tresuren/FC-EXPSYNTH/hardware/RevE5/docs/pcb_render.png

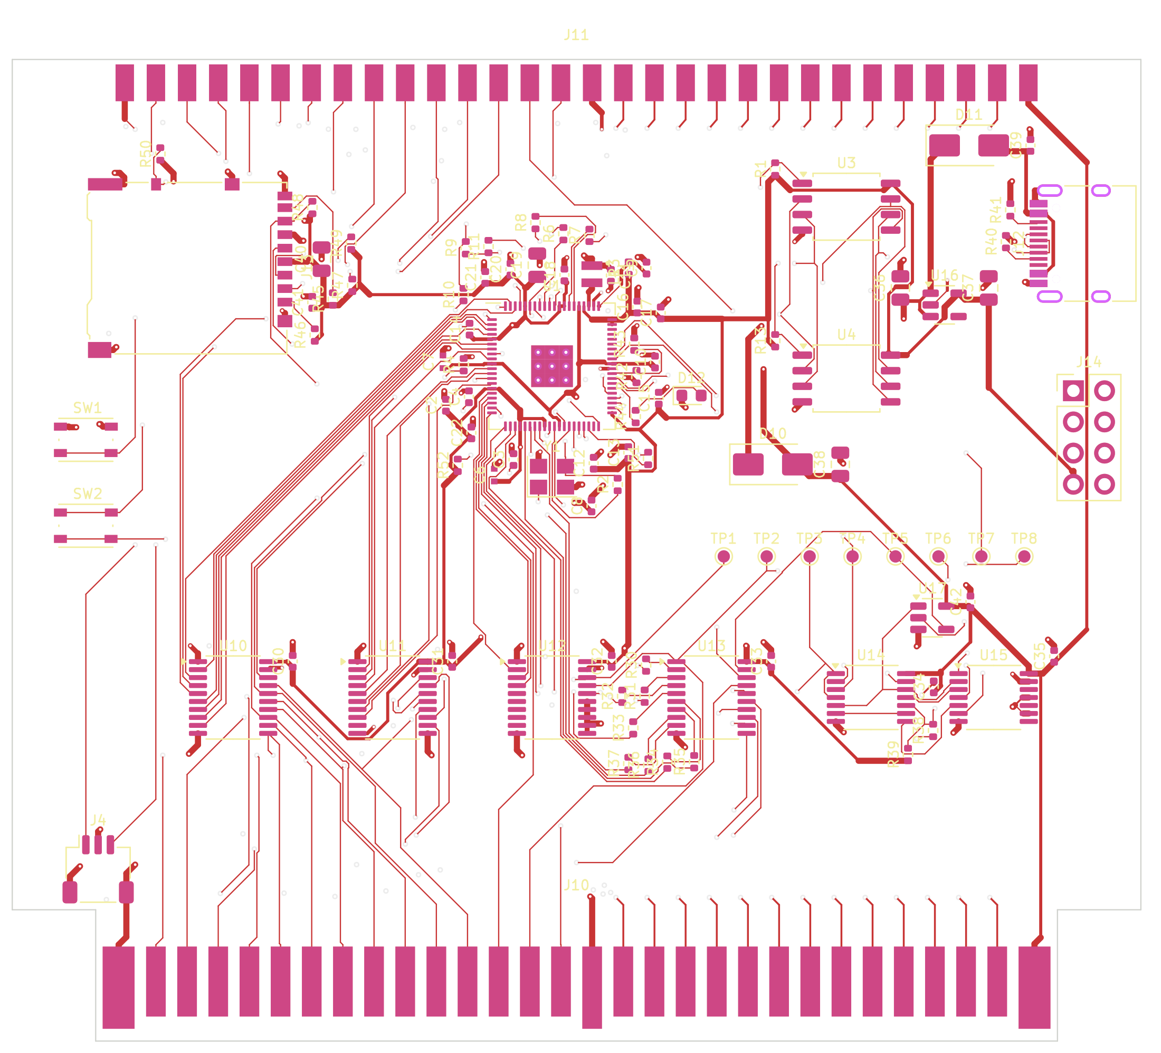
hardware/RevE5/docs/pcb_render.png
