tresuren/FC-EXPSYNTH/hardware/RevE5/docs/pcb_render_back.png

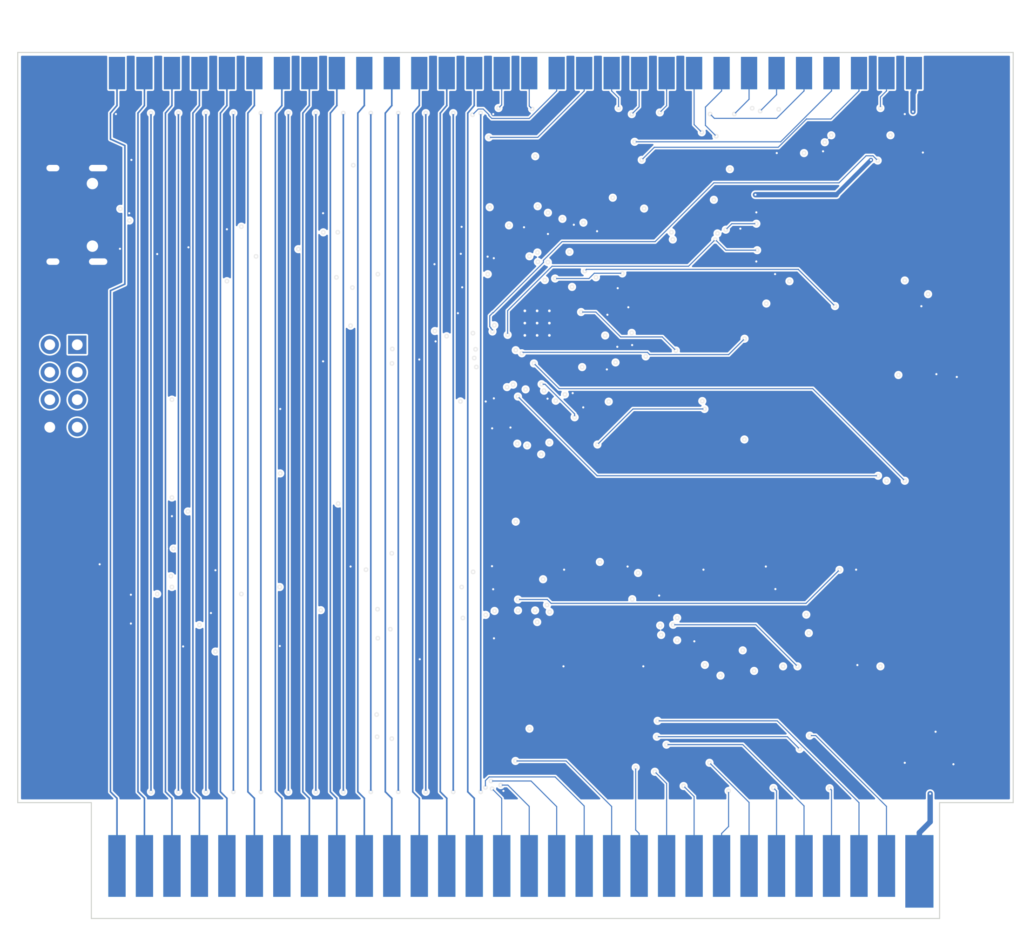
hardware/RevE5/docs/pcb_render_back.png
