tresuren/FC-EXPSYNTH/hardware/RevE5/BOM.csv

Designators | Qty | Value | Footprint | MPN/LCSC (UNVERIFIED - choose yourself)
C2 C8 C11 C12 C13 C14 C15 C16 C17 C18 C20 C21 C30 C31 C32 C33 C34 C35 C39 C41 C42 | 21 | 100n | C_0402_1005Metric
C3 C4 | 2 | 15p | C_0402_1005Metric
C6 C7 | 2 | 4.7u | C_0402_1005Metric_small_pads
C9 C10 | 2 | 4.7u | C_0402_1005Metric
C19 C36 C37 C40 | 4 | 10u | C_0805_2012Metric
C22 | 1 | DNF | C_0402_1005Metric
C38 | 1 | 22u | C_0805_2012Metric
D10 D11 | 2 | SS14 | D_SMA
D12 | 1 | green | LED_0603_1608Metric
J4 | 1 | SM03B-SRSS-TB | JST_SH_SM03B-SRSS-TB_1x03-1MP_P1.00mm_Horizontal
J10 | 1 | FC_Cart_Edge_60 | FC_Cart_Edge_60
J11 | 1 | FC_Slot_60 (expansion cart) | FC_Slot_60 | hand-solder
J12 | 1 | USB-C (HRO TYPE-C-31-M-12) | USB_C_Receptacle_HRO_TYPE-C-31-M-12
J13 | 1 | microSD (SPI) | microSD_HC_Hirose_DM3AT-SF-PEJM5
J14 | 1 | Spare GPIO | PinHeader_2x04_P2.54mm_Vertical
L1 | 1 | 3.3u | L_pol_2016
R1 R9 R11 R13 | 4 | DNF | R_0402_1005Metric
R2 R4 R6 R38 R44 R51 | 6 | 1k | R_0402_1005Metric
R3 | 1 | 33 | R_0402_1005Metric
R7 R8 | 2 | 27 | R_0402_1005Metric
R10 | 1 | 0 | R_0402_1005Metric
R30 R31 R32 R33 R34 R35 R36 R37 | 8 | 330 | R_0402_1005Metric
R39 R42 R45 R46 R47 R48 R49 R50 R52 | 9 | 10k | R_0402_1005Metric
R40 R41 | 2 | 5.1k | R_0402_1005Metric
R43 | 1 | 15k | R_0402_1005Metric
SW1 SW2 | 2 | SW_Push | SW_Push_1P1T_NO_Vertical_Wuerth_434133025816
TP1 | 1 | M2 | TestPoint_Pad_D1.0mm | not assembled (pads only)
TP2 | 1 | RW | TestPoint_Pad_D1.0mm | not assembled (pads only)
TP3 | 1 | ROMSEL_N | TestPoint_Pad_D1.0mm | not assembled (pads only)
TP4 | 1 | ROMSEL_EXP | TestPoint_Pad_D1.0mm | not assembled (pads only)
TP5 | 1 | OE_N | TestPoint_Pad_D1.0mm | not assembled (pads only)
TP6 | 1 | EN_N | TestPoint_Pad_D1.0mm | not assembled (pads only)
TP7 | 1 | GAME | TestPoint_Pad_D1.0mm | not assembled (pads only)
TP8 | 1 | IRQ_N | TestPoint_Pad_D1.0mm | not assembled (pads only)
U1 | 1 | RP2350_80QFN | RP2350-QFN-80-1EP_10x10_P0.4mm_EP3.4x3.4mm_ThermalVias
U3 | 1 | W25Q128JVS | SOIC-8_5.23x5.23mm_P1.27mm
U4 | 1 | DNF | SOIC-8_5.23x5.23mm_P1.27mm
U10 U11 U12 U13 | 4 | 74LVC245 | TSSOP-20_4.4x6.5mm_P0.65mm
U14 | 1 | 74HCT32 | TSSOP-14_4.4x5mm_P0.65mm
U15 | 1 | 74HC04 | TSSOP-14_4.4x5mm_P0.65mm
U16 | 1 | AP2112K-3.3 | SOT-23-5
U17 | 1 | 74LVC1G02 | SOT-23-5
Y1 | 1 | ABM8-272-T3 | Crystal_SMD_3225-4Pin_3.2x2.5mm
