tresuren/FC-EXPSYNTH/hardware/RevE5/docs/fc_sch.pdf

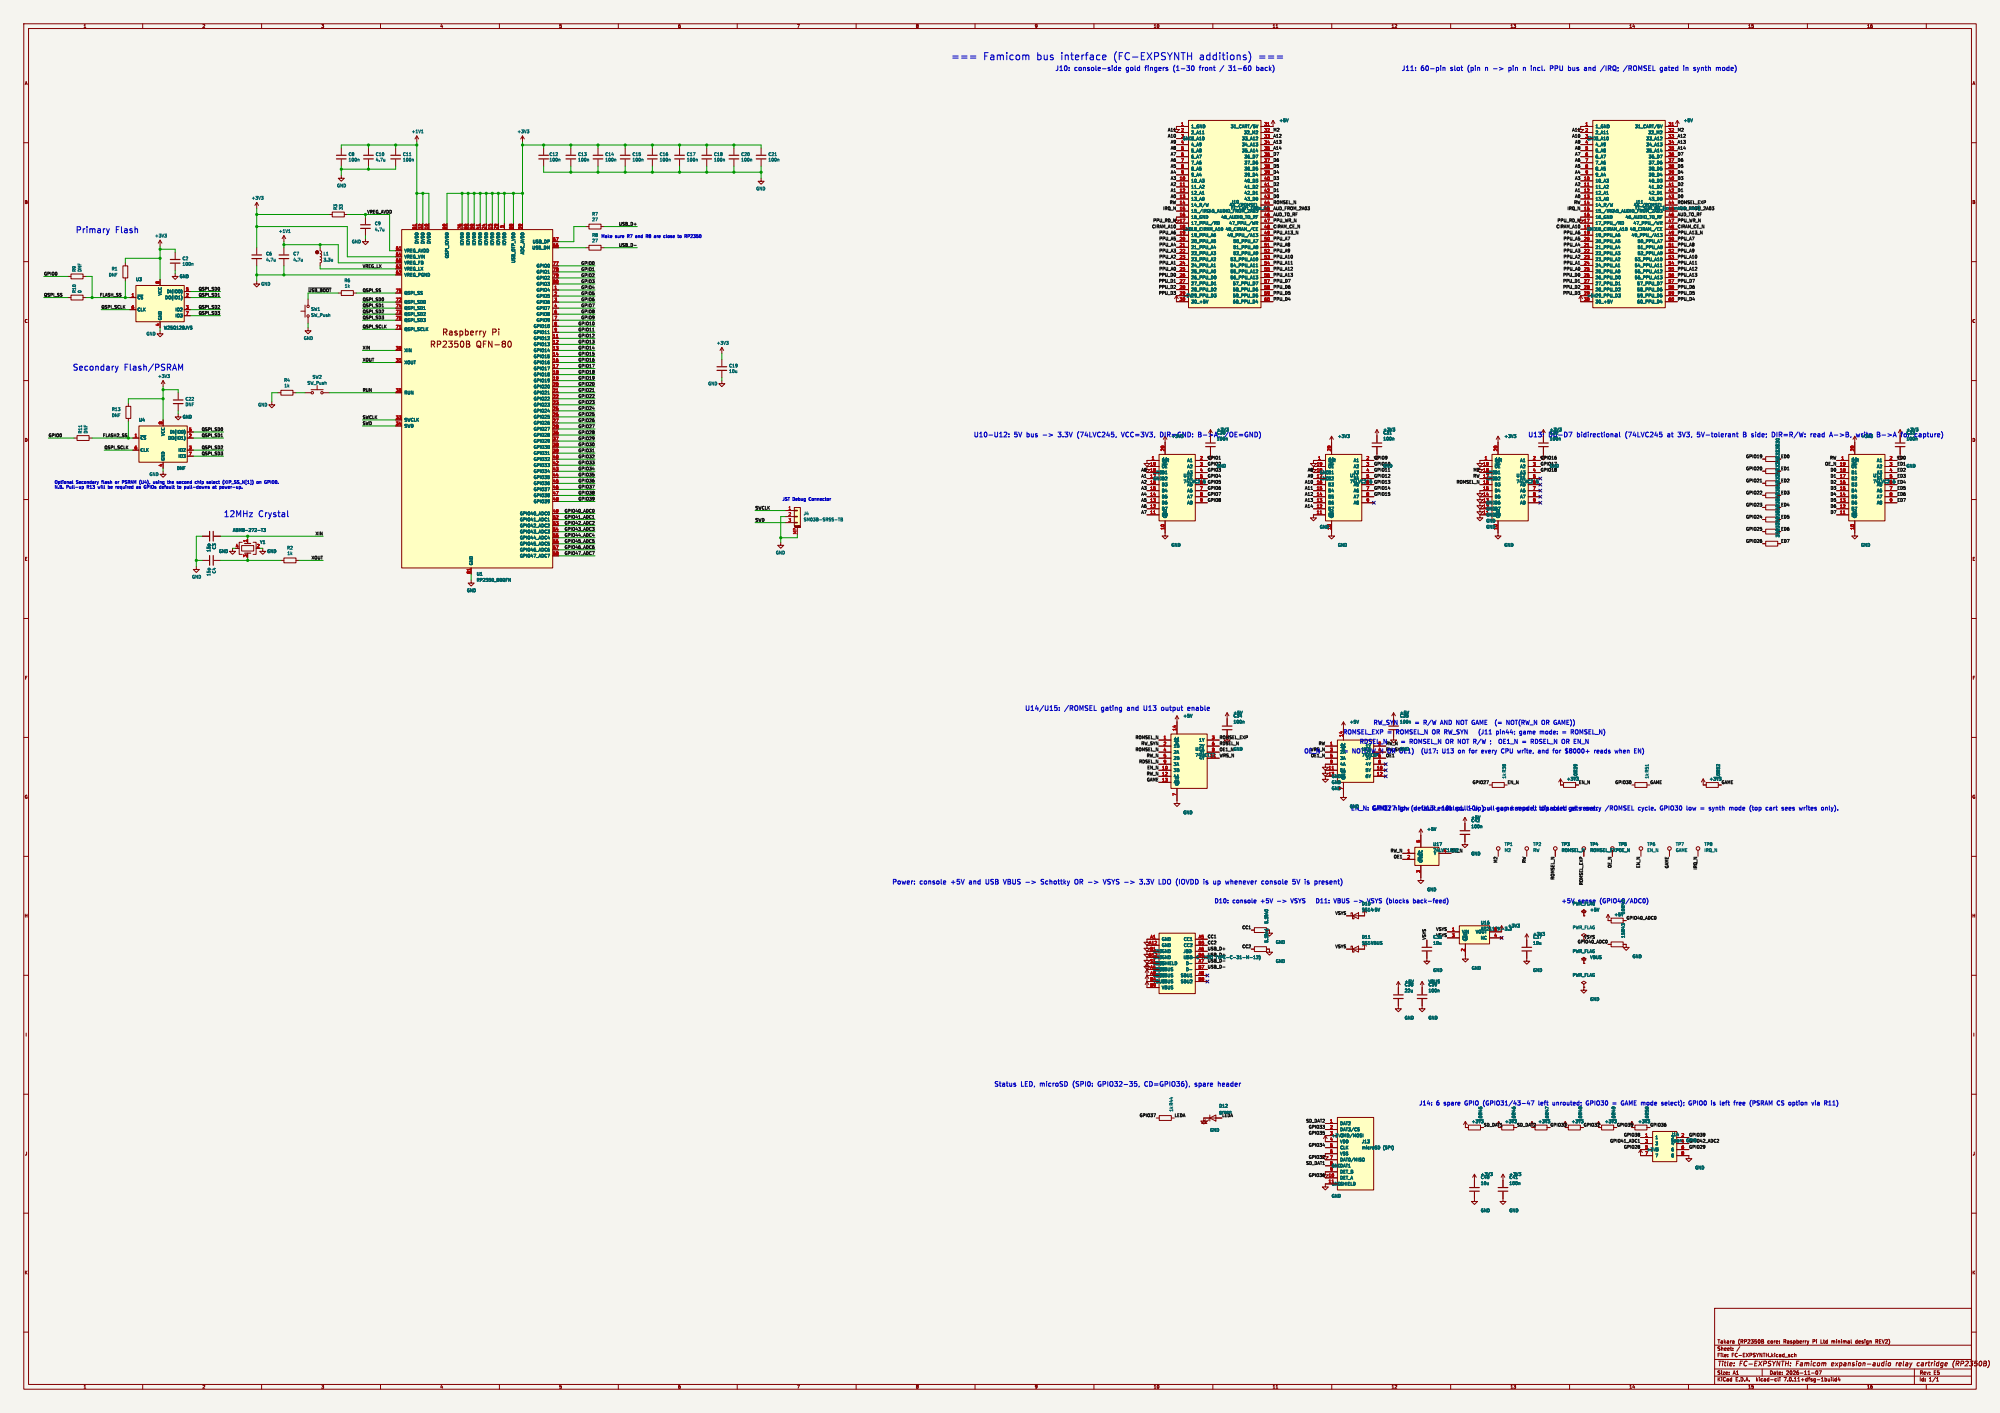
[picture p3: page 1]

5 IOVDD 50 DVDD 51 GPIO41_ADC1 52 GPIO42_ADC2 53 GPIO43_ADC3 54 GPIO44_ADC4 55 GPIO45_ADC5 56 GPIO46_ADC6 57 GPIO47_ADC7 58 ADC_AVDD 59 GPIO8 6 IOVDD 60 VREG_AVDD 61 VREG_PGND 62 VREG_LX 63 VREG_VIN 64 VREG_FB 65 USB_DM 66 USB_DP 67 USB_OTP_VDD 68 QSPI_IOVDD 69 GPIO9 7 QSPI_SD3 70 QSPI_SCLK 71 QSPI_SD0 72 QSPI_SD2 73 QSPI_SD1 74 QSPI_SS 75 IOVDD 76 GPIO0 77 GPIO1 78 GPIO2 79 GPIO10 8 GPIO3 80 GND 81 GPIO11 9 U1 RP2350_80QFN GND GND

5 IOVDD 50 DVDD 51 GPIO41_ADC1 52 GPIO42_ADC2 53 GPIO43_ADC3 54 GPIO44_ADC4 55 GPIO45_ADC5 56 GPIO46_ADC6 57 GPIO47_ADC7 58 ADC_AVDD 59 GPIO8 6 IOVDD 60 VREG_AVDD 61 VREG_PGND 62 VREG_LX 63 VREG_VIN 64 VREG_FB 65 USB_DM 66 USB_DP 67 USB_OTP_VDD 68 QSPI_IOVDD 69 GPIO9 7 QSPI_SD3 70 QSPI_SCLK 71 QSPI_SD0 72 QSPI_SD2 73 QSPI_SD1 74 QSPI_SS 75 IOVDD 76 GPIO0 77 GPIO1 78 GPIO2 79 GPIO10 8 GPIO3 80 GND 81 GPIO11 9 +5V GND

JST Debug Connector Secondary Flash/PSRAM

J12 USB-C (HRO TYPE-C-31-M-12) GND
J12 USB-C (HRO TYPE-C-31-M-12) VBUS
B12 VBUS
VBUS GND GND

A12 VBUS
VBUS GND GND GND
