tresuren/FC-EXPSYNTH/hardware/RevE5/FC-EXPSYNTH.kicad_pcb

## KiCad design hardware/RevE5/FC-EXPSYNTH.kicad_pcb (2026-11-07)

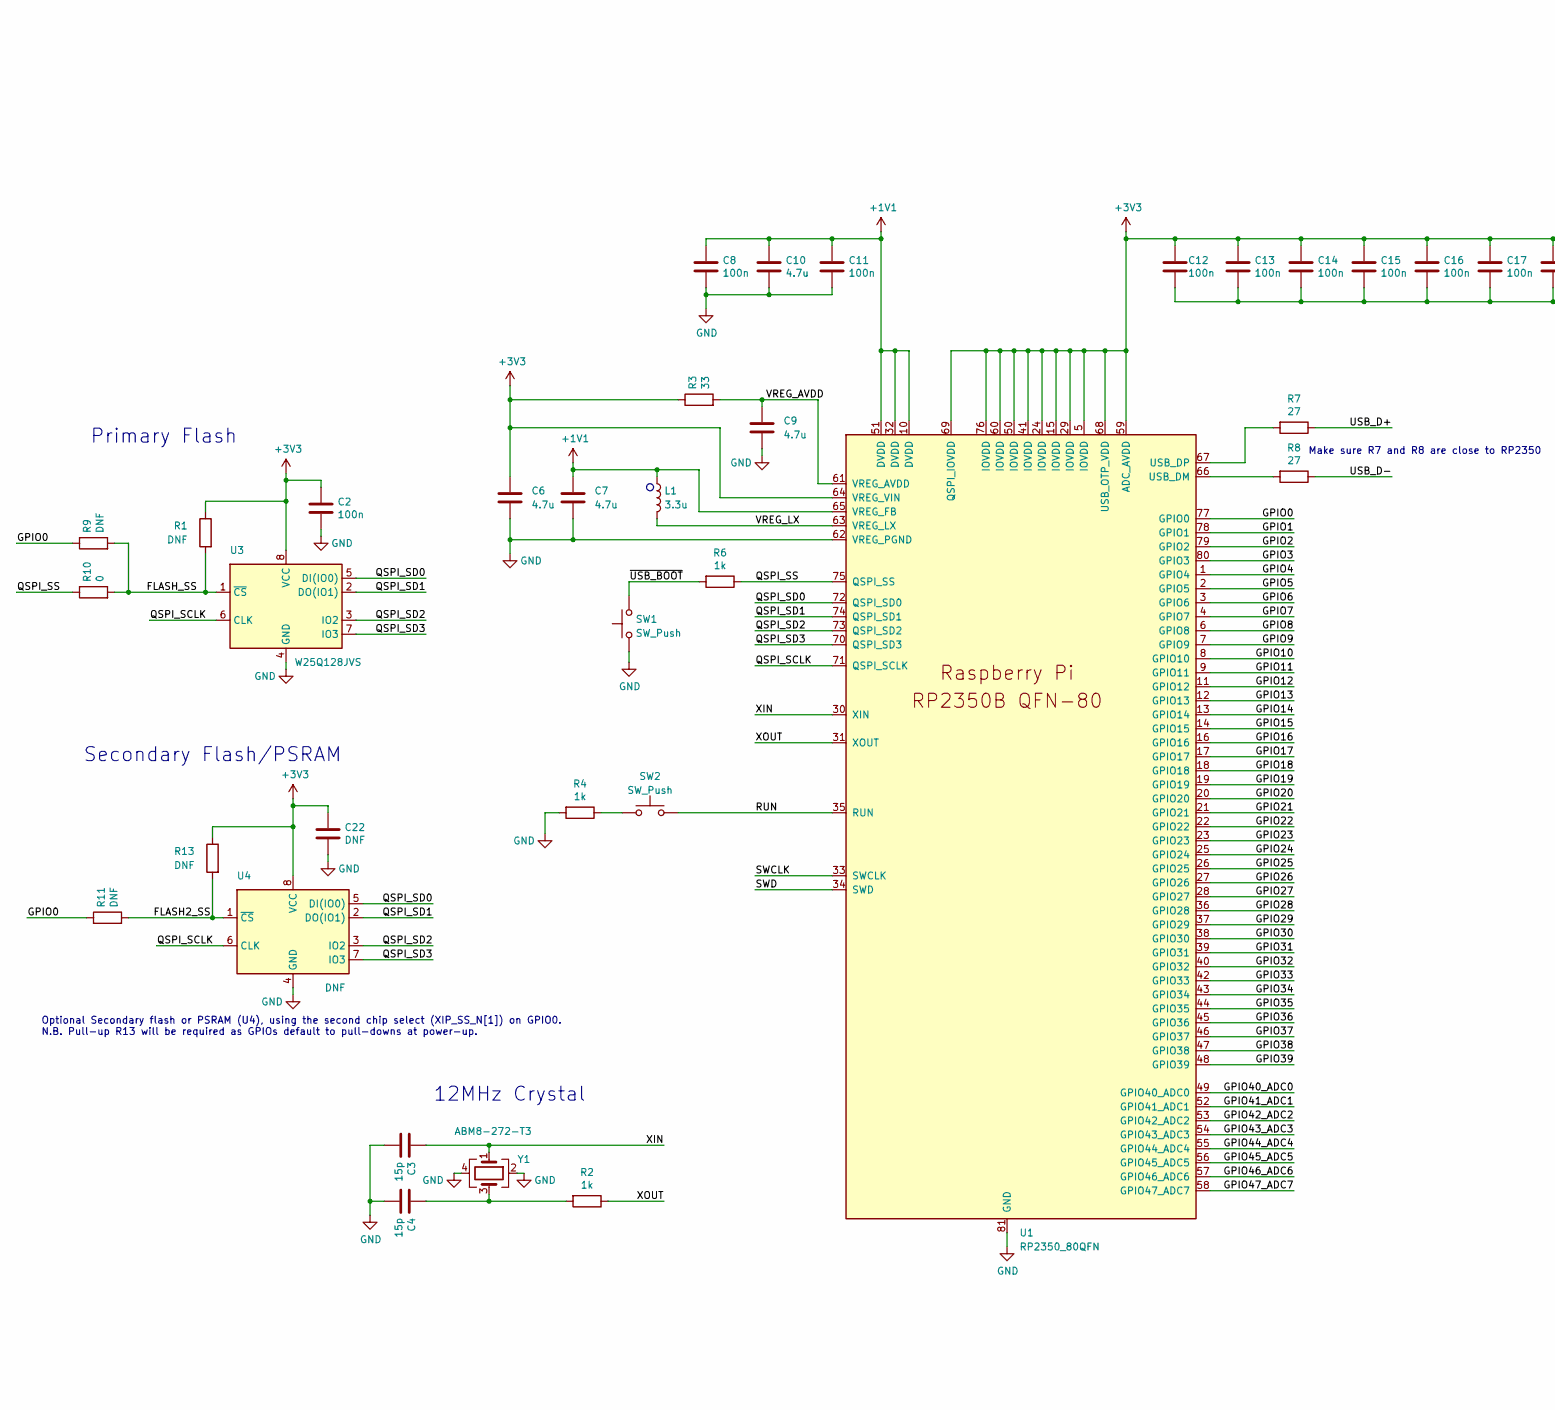
[picture p4: schematic FC-EXPSYNTH.kicad_sch, FC-EXPSYNTH: Famicom expansion-audio relay cartridge (RP235…, part in row 1, column 1]

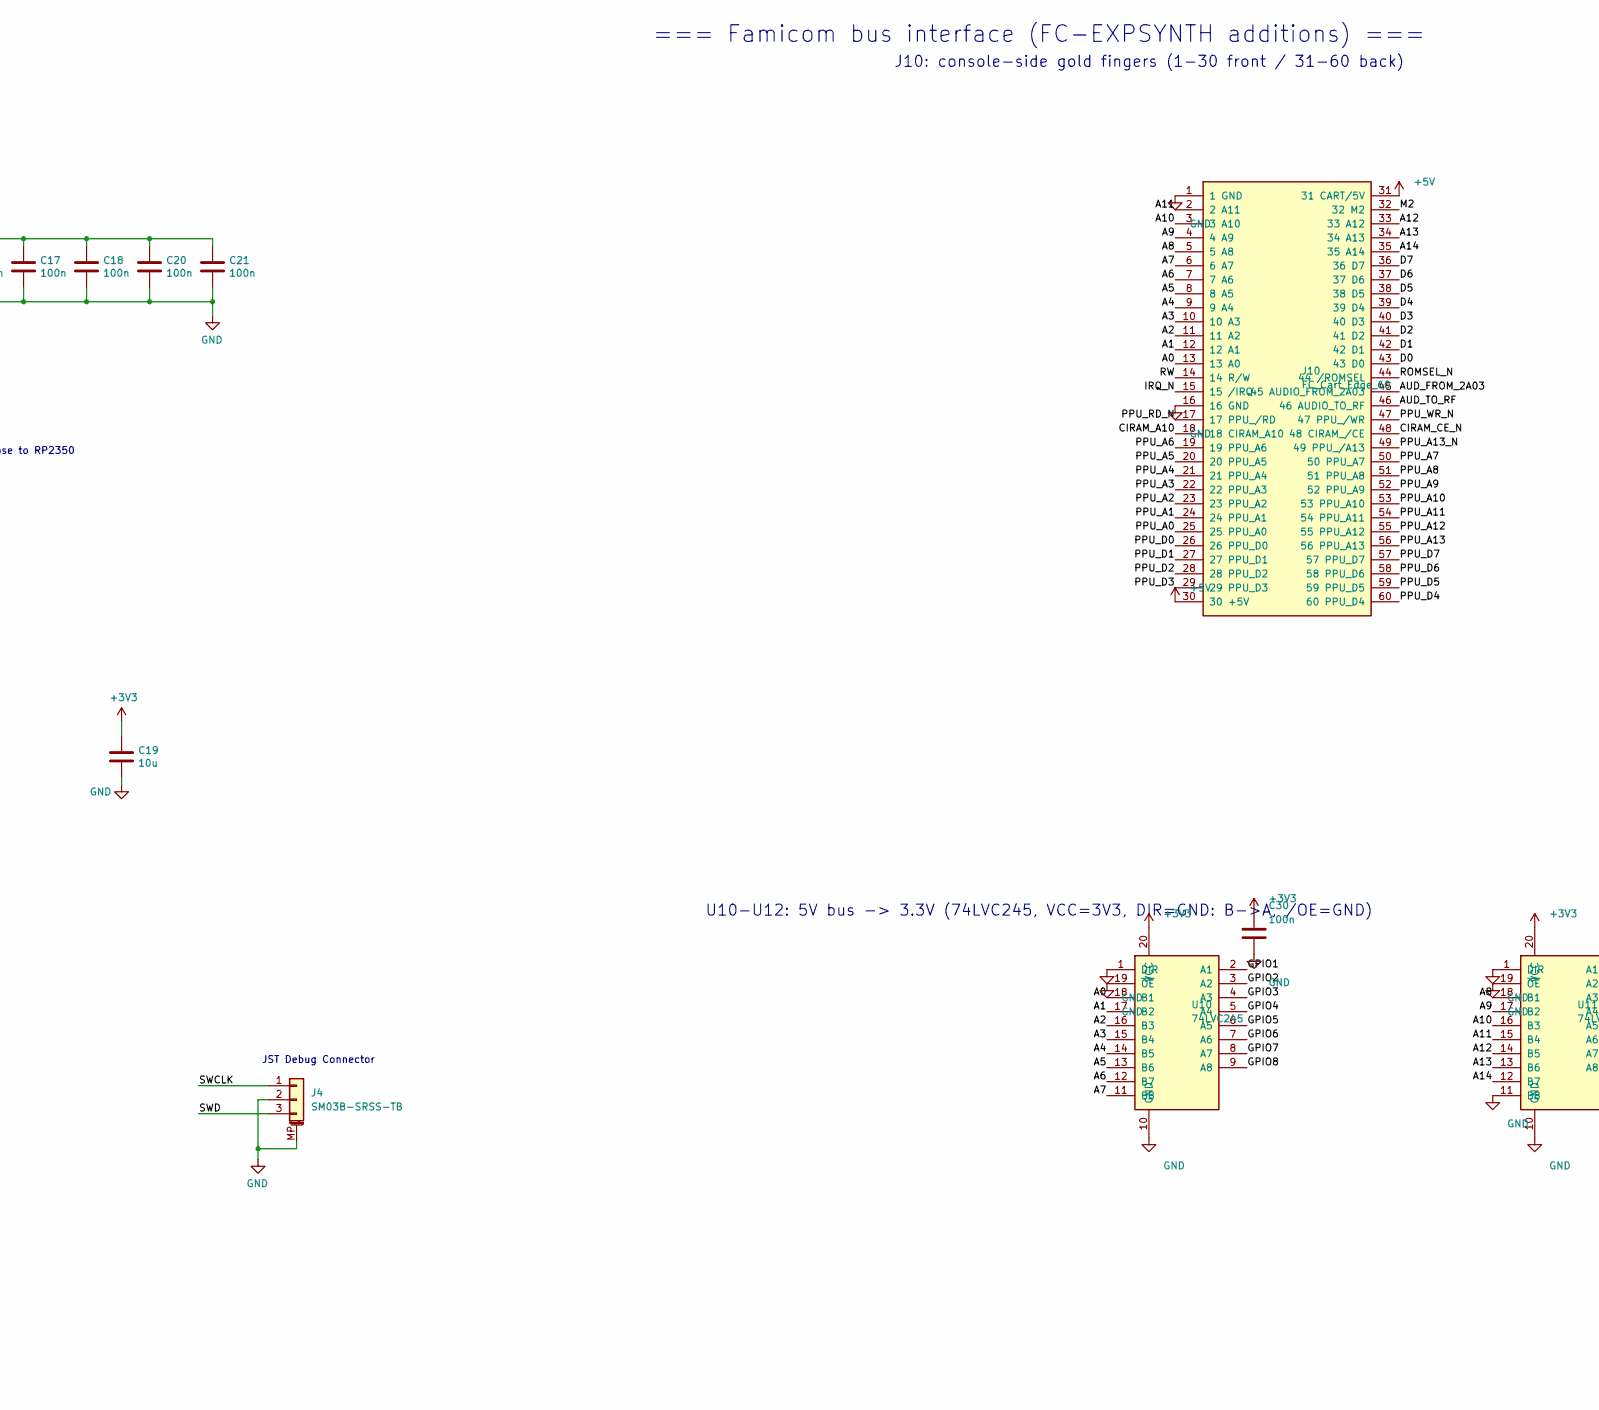
[picture p5: schematic FC-EXPSYNTH.kicad_sch, FC-EXPSYNTH: Famicom expansion-audio relay cartridge (RP235…, part in row 1, column 2]

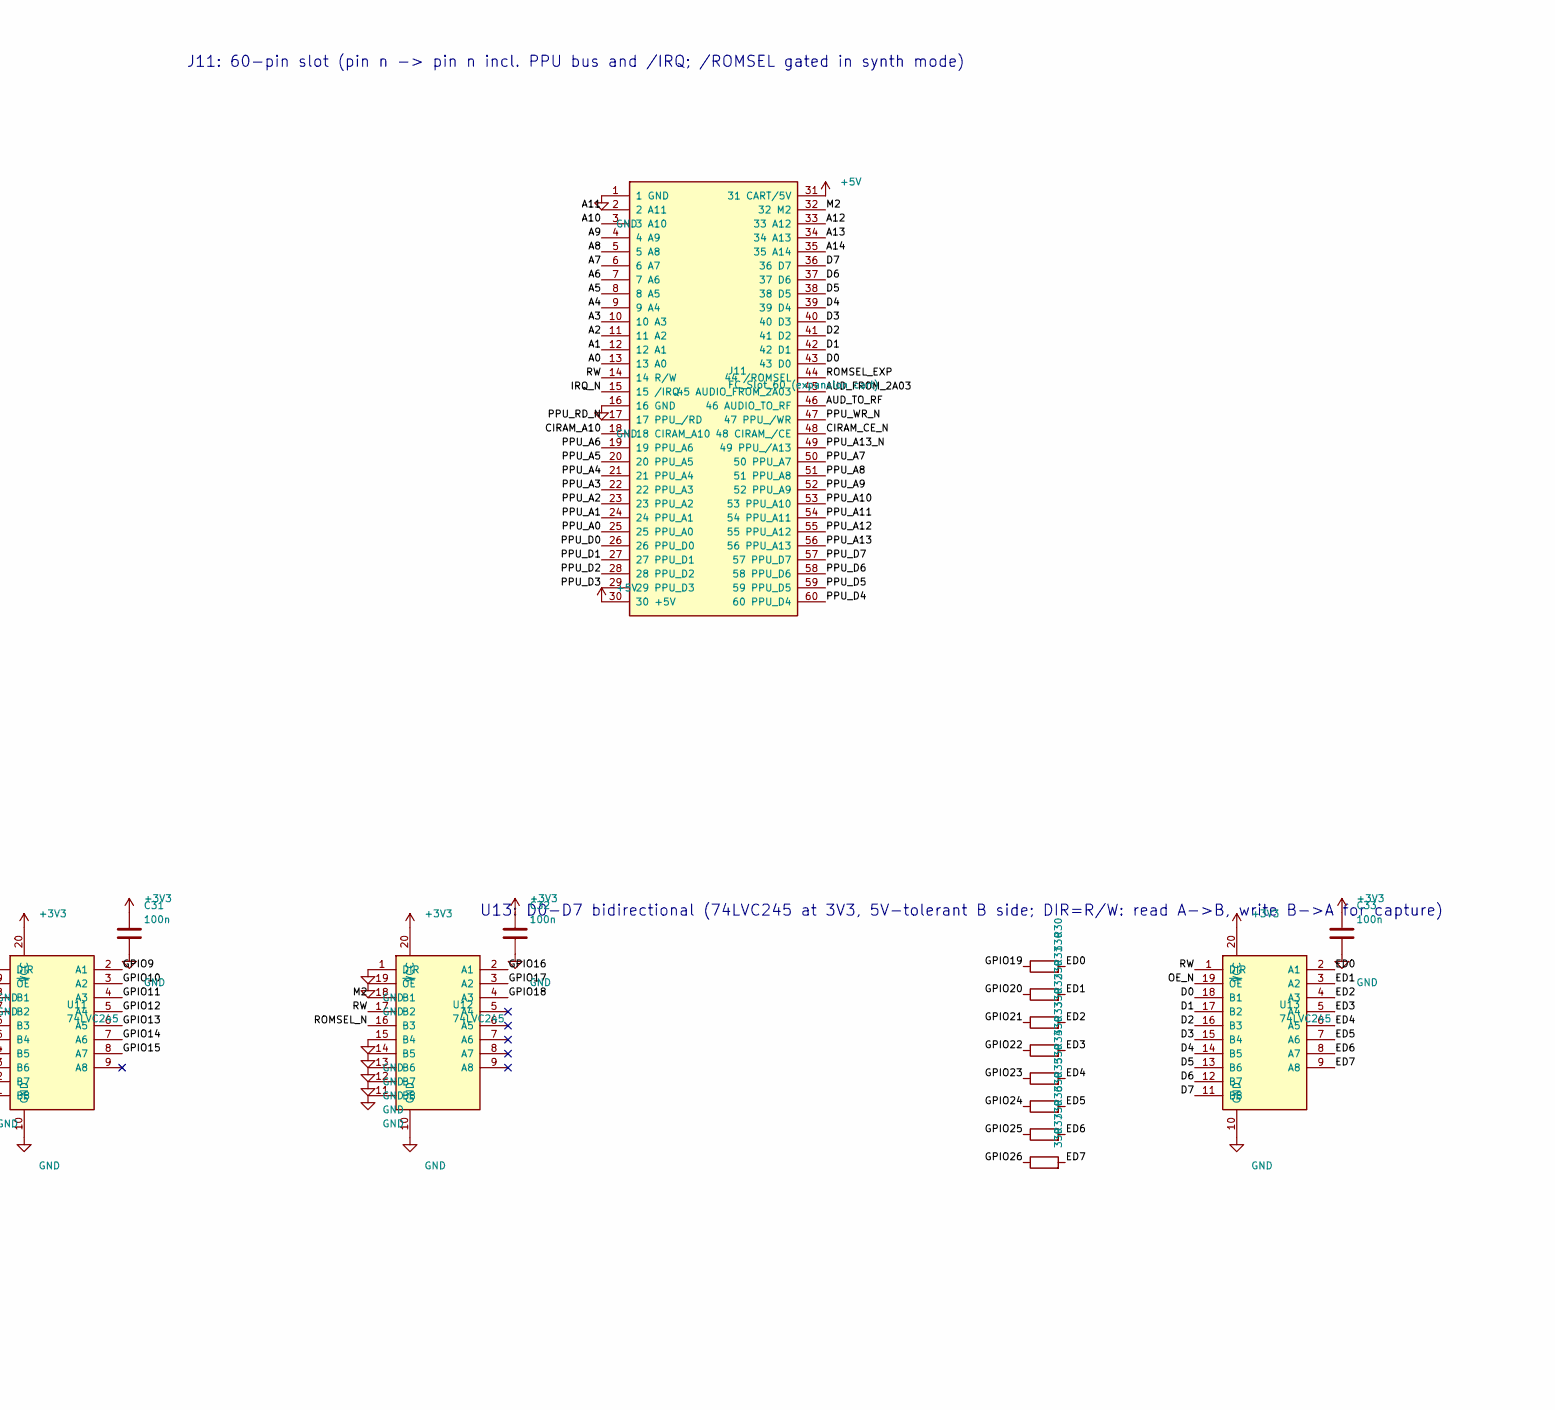
[picture p6: schematic FC-EXPSYNTH.kicad_sch, FC-EXPSYNTH: Famicom expansion-audio relay cartridge (RP235…, part in row 1, column 3]

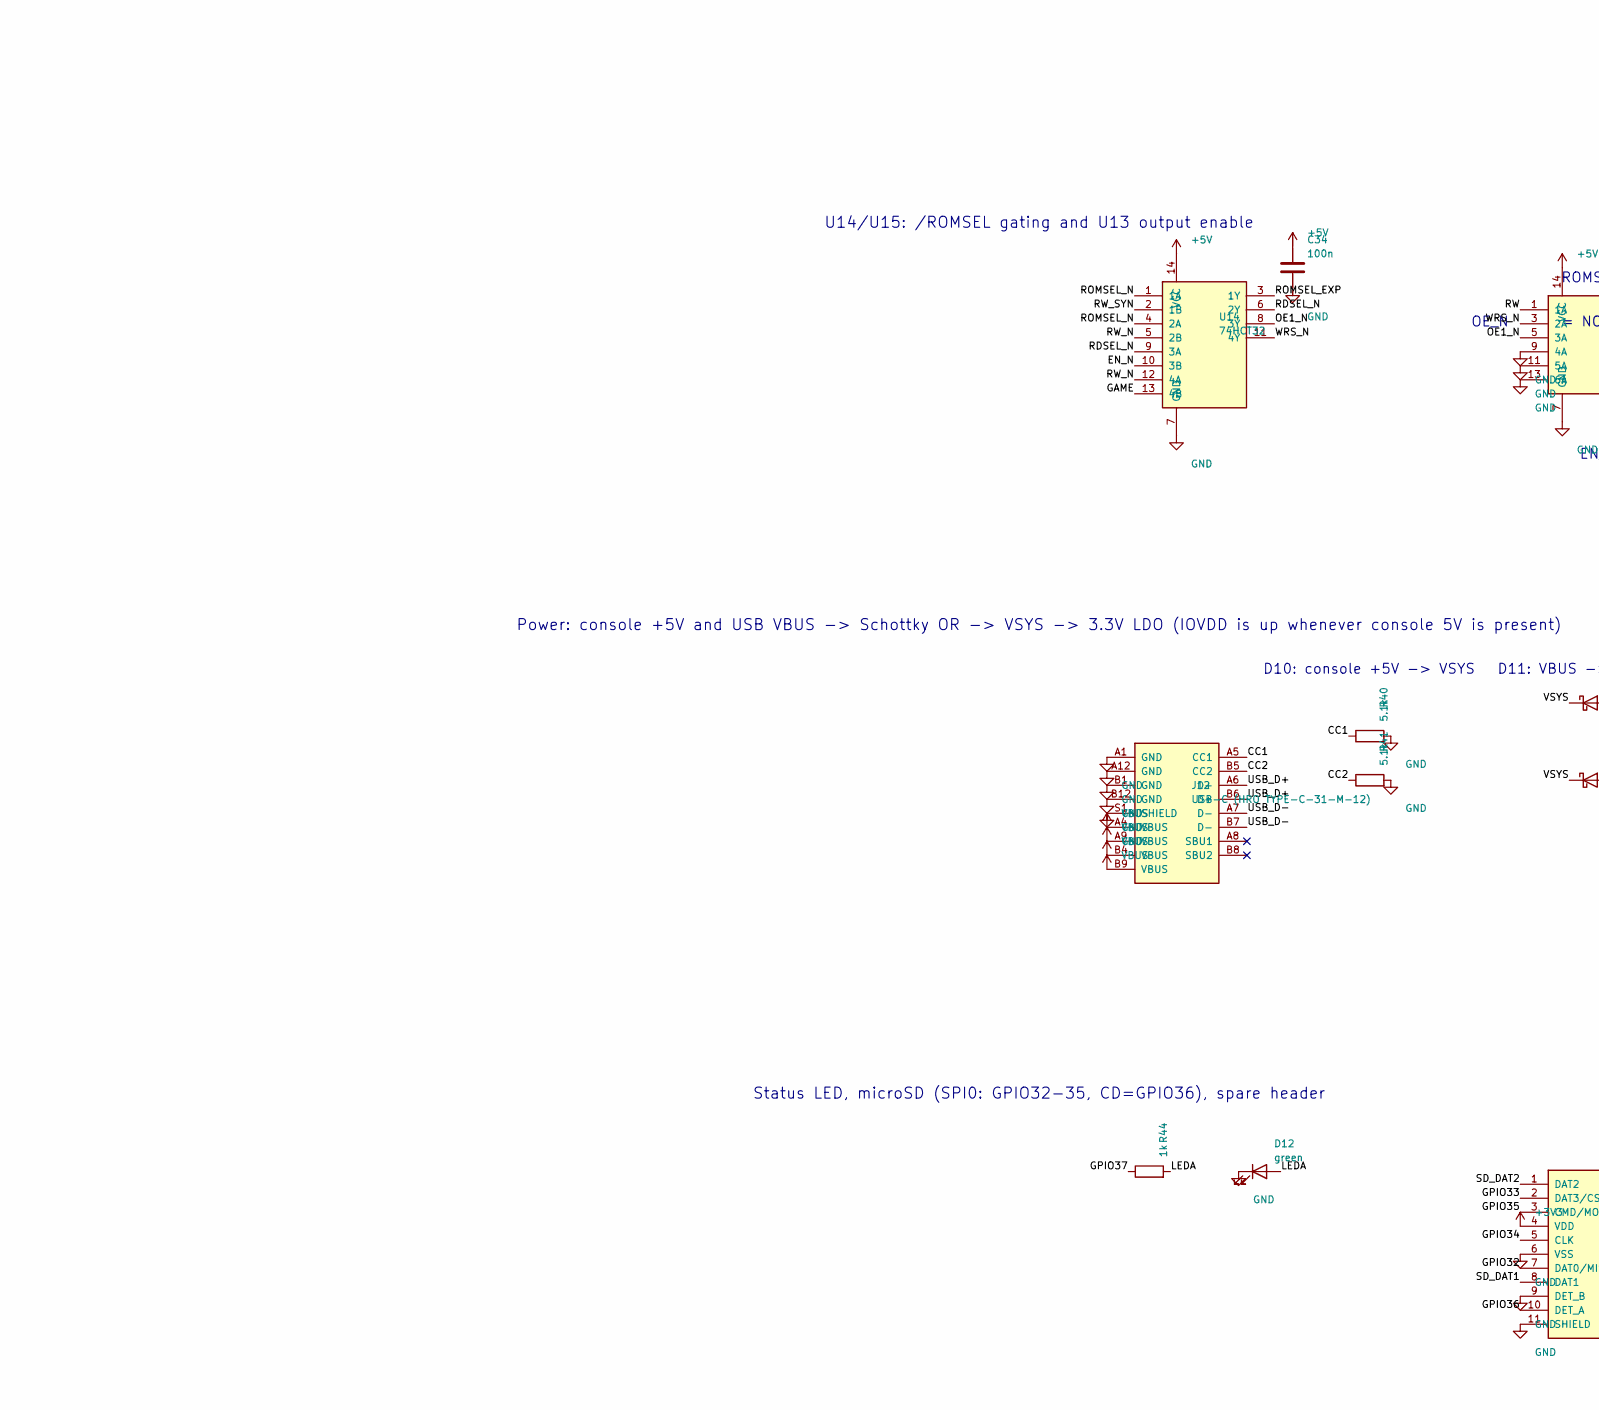
[picture p7: schematic FC-EXPSYNTH.kicad_sch, FC-EXPSYNTH: Famicom expansion-audio relay cartridge (RP235…, part in row 2, column 2]

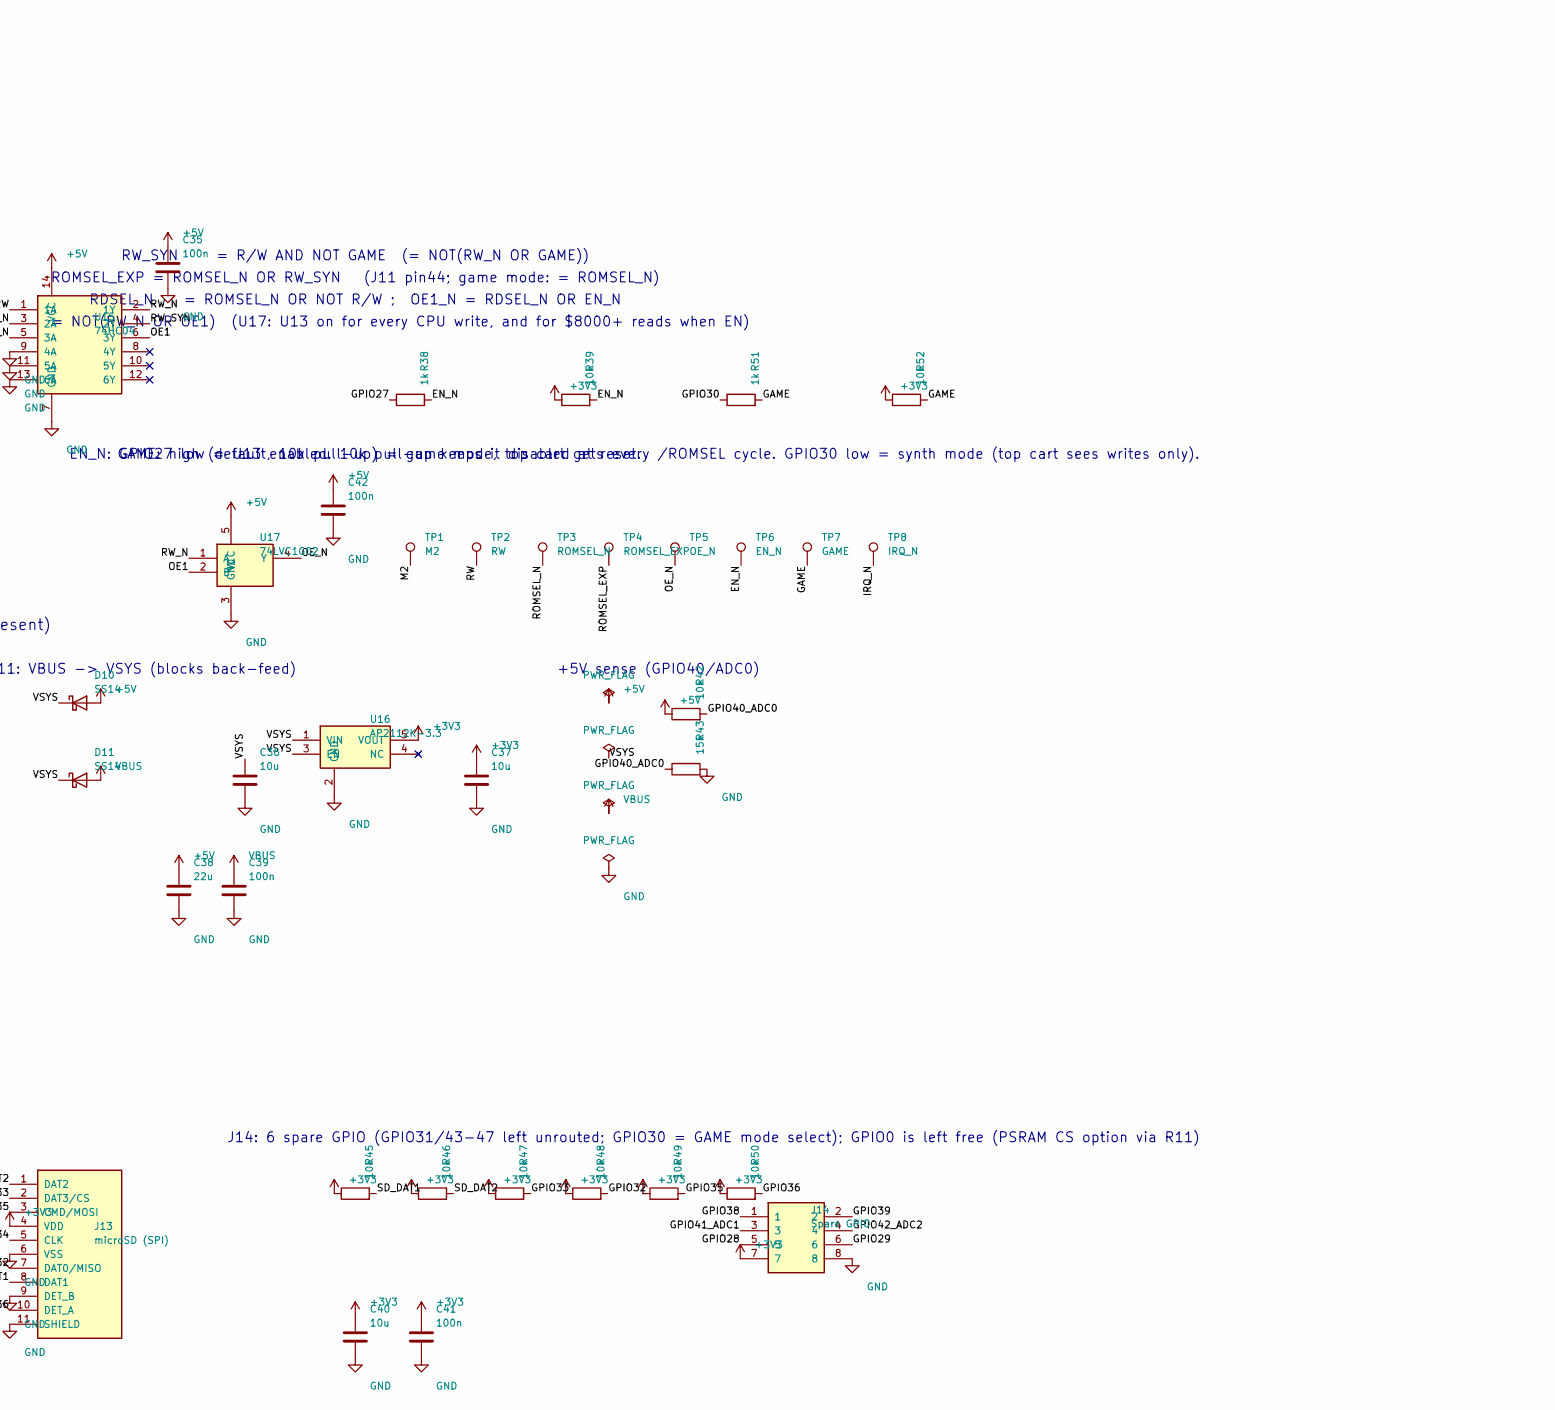
[picture p8: schematic FC-EXPSYNTH.kicad_sch, FC-EXPSYNTH: Famicom expansion-audio relay cartridge (RP235…, part in row 2, column 3]

Parts:
C2, C8, C11, C12, C13, C14, C15, C16, C17, C18, C20, C21, C30, C31, C32, C33, C34, C35, C39, C41, C42: 100n; C_0402_1005Metric
C3, C4: 15p; C_0402_1005Metric
C6, C7: 4.7u; C_0402_1005Metric_small_pads
C9, C10: 4.7u; C_0402_1005Metric
C19, C36, C37, C40: 10u; C_0805_2012Metric
C22: DNF; C_0402_1005Metric
C38: 22u; C_0805_2012Metric
D10, D11: SS14; D_SMA
D12: green; LED_0603_1608Metric
J4: SM03B-SRSS-TB; JST_SH_SM03B-SRSS-TB_1x03-1MP_P1.00mm_Horizontal
J10: FC_Cart_Edge_60
J11: FC_Slot_60 (expansion cart); FC_Slot_60
J12: USB-C (HRO TYPE-C-31-M-12); USB_C_Receptacle_HRO_TYPE-C-31-M-12
J13: microSD (SPI); microSD_HC_Hirose_DM3AT-SF-PEJM5
J14: Spare GPIO; PinHeader_2x04_P2.54mm_Vertical
L1: 3.3u; L_pol_2016
R1, R9, R11, R13: DNF; R_0402_1005Metric
R2, R4, R6, R38, R44, R51: 1k; R_0402_1005Metric
R3: 33; R_0402_1005Metric
R7, R8: 27; R_0402_1005Metric
R10: 0; R_0402_1005Metric
R30, R31, R32, R33, R34, R35, R36, R37: 330; R_0402_1005Metric
R39, R42, R45, R46, R47, R48, R49, R50, R52: 10k; R_0402_1005Metric
R40, R41: 5.1k; R_0402_1005Metric
R43: 15k; R_0402_1005Metric
SW1, SW2: SW_Push; SW_Push_1P1T_NO_Vertical_Wuerth_434133025816
TP1: M2; TestPoint_Pad_D1.0mm
TP2: RW; TestPoint_Pad_D1.0mm
TP3: ROMSEL_N; TestPoint_Pad_D1.0mm
TP4: ROMSEL_EXP; TestPoint_Pad_D1.0mm
TP5: OE_N; TestPoint_Pad_D1.0mm
TP6: EN_N; TestPoint_Pad_D1.0mm
TP7: GAME; TestPoint_Pad_D1.0mm
TP8: IRQ_N; TestPoint_Pad_D1.0mm
U1: RP2350_80QFN; RP2350-QFN-80-1EP_10x10_P0.4mm_EP3.4x3.4mm_ThermalVias
U3: W25Q128JVS; SOIC-8_5.23x5.23mm_P1.27mm
U4: DNF; SOIC-8_5.23x5.23mm_P1.27mm
U10, U11, U12, U13: 74LVC245; TSSOP-20_4.4x6.5mm_P0.65mm
U14: 74HCT32; TSSOP-14_4.4x5mm_P0.65mm
U15: 74HC04; TSSOP-14_4.4x5mm_P0.65mm
U16: AP2112K-3.3; SOT-23-5
U17: 74LVC1G02; SOT-23-5
Y1: ABM8-272-T3; Crystal_SMD_3225-4Pin_3.2x2.5mm

Connections:
+1V1: C7.1, C8.1, C10.1, C11.1, L1.1, U1.10 (DVDD), U1.32 (DVDD), U1.51 (DVDD), U1.65 (VREG_FB)
+3V3: C2.1, C6.1, C12.1, C13.1, C14.1, C15.1, C16.1, C17.1, C18.1, C19.1, C20.1, C21.1, C22.1, C30.1, C31.1, C32.1, C33.1, C37.1, C40.1, C41.1, J13.4 (VDD), J14.7, R1.1, R3.1, R13.1, R39.1, R45.1, R46.1, R47.1, R48.1, R49.1, R50.1, R52.1, U1.5 (IOVDD), U1.15 (IOVDD), U1.24 (IOVDD), U1.29 (IOVDD), U1.41 (IOVDD), U1.50 (IOVDD), U1.59 (ADC_AVDD), U1.60 (IOVDD), U1.64 (VREG_VIN), U1.68 (USB_OTP_VDD), U1.69 (QSPI_IOVDD), U1.76 (IOVDD), U3.8 (VCC), U4.8 (VCC), U10.20 (VCC), U11.20 (VCC), U12.20 (VCC), U13.20 (VCC), U16.5 (VOUT)
+5V: C34.1, C35.1, C38.1, C42.1, D10.2 (A), J10.30 (30 +5V), J10.31 (31 CART/5V), J11.30 (30 +5V), J11.31 (31 CART/5V), R42.1, U14.14 (VCC), U15.14 (VCC), U17.5 (VCC)
/A0: J10.13 (13 A0), J11.13 (13 A0), U10.18 (B1)
/A1: J10.12 (12 A1), J11.12 (12 A1), U10.17 (B2)
/A2: J10.11 (11 A2), J11.11 (11 A2), U10.16 (B3)
/A3: J10.10 (10 A3), J11.10 (10 A3), U10.15 (B4)
/A4: J10.9 (9 A4), J11.9 (9 A4), U10.14 (B5)
/A5: J10.8 (8 A5), J11.8 (8 A5), U10.13 (B6)
/A6: J10.7 (7 A6), J11.7 (7 A6), U10.12 (B7)
/A7: J10.6 (6 A7), J11.6 (6 A7), U10.11 (B8)
/A8: J10.5 (5 A8), J11.5 (5 A8), U11.18 (B1)
/A9: J10.4 (4 A9), J11.4 (4 A9), U11.17 (B2)
/A10: J10.3 (3 A10), J11.3 (3 A10), U11.16 (B3)
/A11: J10.2 (2 A11), J11.2 (2 A11), U11.15 (B4)
/A12: J10.33 (33 A12), J11.33 (33 A12), U11.14 (B5)
/A13: J10.34 (34 A13), J11.34 (34 A13), U11.13 (B6)
/A14: J10.35 (35 A14), J11.35 (35 A14), U11.12 (B7)
/AUD_FROM_2A03: J10.45 (45 AUDIO_FROM_2A03), J11.45 (45 AUDIO_FROM_2A03)
/AUD_TO_RF: J10.46 (46 AUDIO_TO_RF), J11.46 (46 AUDIO_TO_RF)
/CC1: J12.A5 (CC1), R40.1
/CC2: J12.B5 (CC2), R41.1
/CIRAM_A10: J10.18 (18 CIRAM_A10), J11.18 (18 CIRAM_A10)
/CIRAM_CE_N: J10.48 (48 CIRAM_/CE), J11.48 (48 CIRAM_/CE)
/D0: J10.43 (43 D0), J11.43 (43 D0), U13.18 (B1)
/D1: J10.42 (42 D1), J11.42 (42 D1), U13.17 (B2)
/D2: J10.41 (41 D2), J11.41 (41 D2), U13.16 (B3)
/D3: J10.40 (40 D3), J11.40 (40 D3), U13.15 (B4)
/D4: J10.39 (39 D4), J11.39 (39 D4), U13.14 (B5)
/D5: J10.38 (38 D5), J11.38 (38 D5), U13.13 (B6)
/D6: J10.37 (37 D6), J11.37 (37 D6), U13.12 (B7)
/D7: J10.36 (36 D7), J11.36 (36 D7), U13.11 (B8)
/ED0: R30.2, U13.2 (A1)
/ED1: R31.2, U13.3 (A2)
/ED2: R32.2, U13.4 (A3)
/ED3: R33.2, U13.5 (A4)
/ED4: R34.2, U13.6 (A5)
/ED5: R35.2, U13.7 (A6)
/ED6: R36.2, U13.8 (A7)
/ED7: R37.2, U13.9 (A8)
/EN_N: R38.2, R39.2, TP6.1, U14.10 (3B)
/FLASH2_SS: R11.2, R13.2, U4.1 (~CS)
/FLASH_SS: R1.2, R9.2, R10.2, U3.1 (~CS)
/GAME: R51.2, R52.2, TP7.1, U14.13 (4B)
/GPIO0: R9.1, R11.1, U1.77 (GPIO0)
/GPIO1: U1.78 (GPIO1), U10.2 (A1)
/GPIO2: U1.79 (GPIO2), U10.3 (A2)
/GPIO3: U1.80 (GPIO3), U10.4 (A3)
/GPIO4: U1.1 (GPIO4), U10.5 (A4)
/GPIO5: U1.2 (GPIO5), U10.6 (A5)
/GPIO6: U1.3 (GPIO6), U10.7 (A6)
/GPIO7: U1.4 (GPIO7), U10.8 (A7)
/GPIO8: U1.6 (GPIO8), U10.9 (A8)
/GPIO9: U1.7 (GPIO9), U11.2 (A1)
/GPIO10: U1.8 (GPIO10), U11.3 (A2)
/GPIO11: U1.9 (GPIO11), U11.4 (A3)
/GPIO12: U1.11 (GPIO12), U11.5 (A4)
/GPIO13: U1.12 (GPIO13), U11.6 (A5)
/GPIO14: U1.13 (GPIO14), U11.7 (A6)
/GPIO15: U1.14 (GPIO15), U11.8 (A7)
/GPIO16: U1.16 (GPIO16), U12.2 (A1)
/GPIO17: U1.17 (GPIO17), U12.3 (A2)
/GPIO18: U1.18 (GPIO18), U12.4 (A3)
/GPIO19: R30.1, U1.19 (GPIO19)
/GPIO20: R31.1, U1.20 (GPIO20)
/GPIO21: R32.1, U1.21 (GPIO21)
/GPIO22: R33.1, U1.22 (GPIO22)
/GPIO23: R34.1, U1.23 (GPIO23)
/GPIO24: R35.1, U1.25 (GPIO24)
/GPIO25: R36.1, U1.26 (GPIO25)
/GPIO26: R37.1, U1.27 (GPIO26)
/GPIO27: R38.1, U1.28 (GPIO27)
/GPIO28: J14.5, U1.36 (GPIO28)
/GPIO29: J14.6, U1.37 (GPIO29)
/GPIO30: R51.1, U1.38 (GPIO30)
/GPIO31: U1.39 (GPIO31)
/GPIO32: J13.7 (DAT0/MISO), R48.2, U1.40 (GPIO32)
/GPIO33: J13.2 (DAT3/CS), R47.2, U1.42 (GPIO33)
/GPIO34: J13.5 (CLK), U1.43 (GPIO34)
/GPIO35: J13.3 (CMD/MOSI), R49.2, U1.44 (GPIO35)
/GPIO36: J13.10 (DET_A), R50.2, U1.45 (GPIO36)
/GPIO37: R44.1, U1.46 (GPIO37)
/GPIO38: J14.1, U1.47 (GPIO38)
/GPIO39: J14.2, U1.48 (GPIO39)
/GPIO40_ADC0: R42.2, R43.1, U1.49 (GPIO40_ADC0)
/GPIO41_ADC1: J14.3, U1.52 (GPIO41_ADC1)
/GPIO42_ADC2: J14.4, U1.53 (GPIO42_ADC2)
/GPIO43_ADC3: U1.54 (GPIO43_ADC3)
/GPIO44_ADC4: U1.55 (GPIO44_ADC4)
/GPIO45_ADC5: U1.56 (GPIO45_ADC5)
/GPIO46_ADC6: U1.57 (GPIO46_ADC6)
/GPIO47_ADC7: U1.58 (GPIO47_ADC7)
/IRQ_N: J10.15 (15 /IRQ), J11.15 (15 /IRQ), TP8.1
/LEDA: D12.2 (A), R44.2
/M2: J10.32 (32 M2), J11.32 (32 M2), TP1.1, U12.18 (B1)
/OE1: U15.6 (3Y), U17.2 (B)
/OE1_N: U14.8 (3Y), U15.5 (3A)
/OE_N: TP5.1, U13.19 (~OE), U17.4 (Y)
/PPU_A0: J10.25 (25 PPU_A0), J11.25 (25 PPU_A0)
/PPU_A1: J10.24 (24 PPU_A1), J11.24 (24 PPU_A1)
/PPU_A2: J10.23 (23 PPU_A2), J11.23 (23 PPU_A2)
/PPU_A3: J10.22 (22 PPU_A3), J11.22 (22 PPU_A3)
/PPU_A4: J10.21 (21 PPU_A4), J11.21 (21 PPU_A4)
/PPU_A5: J10.20 (20 PPU_A5), J11.20 (20 PPU_A5)
/PPU_A6: J10.19 (19 PPU_A6), J11.19 (19 PPU_A6)
/PPU_A7: J10.50 (50 PPU_A7), J11.50 (50 PPU_A7)
/PPU_A8: J10.51 (51 PPU_A8), J11.51 (51 PPU_A8)
/PPU_A9: J10.52 (52 PPU_A9), J11.52 (52 PPU_A9)
/PPU_A10: J10.53 (53 PPU_A10), J11.53 (53 PPU_A10)
/PPU_A11: J10.54 (54 PPU_A11), J11.54 (54 PPU_A11)
/PPU_A12: J10.55 (55 PPU_A12), J11.55 (55 PPU_A12)
/PPU_A13: J10.56 (56 PPU_A13), J11.56 (56 PPU_A13)
/PPU_A13_N: J10.49 (49 PPU_/A13), J11.49 (49 PPU_/A13)
/PPU_D0: J10.26 (26 PPU_D0), J11.26 (26 PPU_D0)
/PPU_D1: J10.27 (27 PPU_D1), J11.27 (27 PPU_D1)
/PPU_D2: J10.28 (28 PPU_D2), J11.28 (28 PPU_D2)
/PPU_D3: J10.29 (29 PPU_D3), J11.29 (29 PPU_D3)
/PPU_D4: J10.60 (60 PPU_D4), J11.60 (60 PPU_D4)
/PPU_D5: J10.59 (59 PPU_D5), J11.59 (59 PPU_D5)
/PPU_D6: J10.58 (58 PPU_D6), J11.58 (58 PPU_D6)
/PPU_D7: J10.57 (57 PPU_D7), J11.57 (57 PPU_D7)
/PPU_RD_N: J10.17 (17 PPU_/RD), J11.17 (17 PPU_/RD)
/PPU_WR_N: J10.47 (47 PPU_/WR), J11.47 (47 PPU_/WR)
/QSPI_SCLK: U1.71 (QSPI_SCLK), U3.6 (CLK), U4.6 (CLK)
/QSPI_SD0: U1.72 (QSPI_SD0), U3.5 (DI(IO0)), U4.5 (DI(IO0))
/QSPI_SD1: U1.74 (QSPI_SD1), U3.2 (DO(IO1)), U4.2 (DO(IO1))
/QSPI_SD2: U1.73 (QSPI_SD2), U3.3 (IO2), U4.3 (IO2)
/QSPI_SD3: U1.70 (QSPI_SD3), U3.7 (IO3), U4.7 (IO3)
/QSPI_SS: R6.1, R10.1, U1.75 (QSPI_SS)
/RDSEL_N: U14.6 (2Y), U14.9 (3A)
/ROMSEL_EXP: J11.44 (44 /ROMSEL), TP4.1, U14.3 (1Y)
/ROMSEL_N: J10.44 (44 /ROMSEL), TP3.1, U12.16 (B3), U14.1 (1A), U14.4 (2A)
/RUN: SW2.2, U1.35 (RUN)
/RW: J10.14 (14 R/W), J11.14 (14 R/W), TP2.1, U12.17 (B2), U13.1 (DIR), U15.1 (1A)
/RW_N: U14.5 (2B), U14.12 (4A), U15.2 (1Y), U17.1 (A)
/RW_SYN: U14.2 (1B), U15.4 (2Y)
/SD_DAT1: J13.8 (DAT1), R45.2
/SD_DAT2: J13.1 (DAT2), R46.2
/SWCLK: J4.1, U1.33 (SWCLK)
/SWD: J4.3, U1.34 (SWD)
/USB_D+: J12.A6 (D+), J12.B6 (D+), R7.1
/USB_D-: J12.A7 (D-), J12.B7 (D-), R8.1
/VREG_AVDD: C9.1, R3.2, U1.61 (VREG_AVDD)
/VREG_LX: L1.2, U1.63 (VREG_LX)
/VSYS: C36.1, D10.1 (K), D11.1 (K), U16.1 (VIN), U16.3 (EN)
/WRS_N: U14.11 (4Y), U15.3 (2A)
/XIN: C3.1, U1.30 (XIN), Y1.1
/XOUT: R2.1, U1.31 (XOUT)
/~USB_BOOT: R6.2, SW1.2
GND: C2.2, C3.2, C4.2, C6.2, C7.2, C8.2, C9.2, C10.2, C11.2, C12.2, C13.2, C14.2, C15.2, C16.2, C17.2, C18.2, C19.2, C20.2, C21.2, C22.2, C30.2, C31.2, C32.2, C33.2, C34.2, C35.2, C36.2, C37.2, C38.2, C39.2, C40.2, C41.2, C42.2, D12.1 (K), J4.2, J4.MP (MountPin), J10.1 (1 GND), J10.16 (16 GND), J11.1 (1 GND), J11.16 (16 GND), J12.A1 (GND), J12.A12 (GND), J12.B1 (GND), J12.B12 (GND), J12.S1 (SHIELD), J13.6 (VSS), J13.9 (DET_B), J13.11 (SHIELD), J14.8, R4.2, R40.2, R41.2, R43.2, SW1.1, U1.62 (VREG_PGND), U1.81 (GND), U3.4 (GND), U4.4 (GND), U10.1 (DIR), U10.10 (GND), U10.19 (~OE), U11.1 (DIR), U11.10 (GND), U11.11 (B8), U11.19 (~OE), U12.1 (DIR), U12.10 (GND), U12.11 (B8), U12.12 (B7), U12.13 (B6), U12.14 (B5), U12.15 (B4), U12.19 (~OE), U13.10 (GND), U14.7 (GND), U15.7 (GND), U15.9 (4A), U15.11 (5A), U15.13 (6A), U16.2 (GND), U17.3 (GND), Y1.2, Y1.4
unnamed: C4.1, R2.2, Y1.3
unnamed: R4.1, SW2.1
unnamed: R8.2, U1.66 (USB_DM)
unnamed: R7.2, U1.67 (USB_DP)
VBUS: C39.1, D11.2 (A), J12.A4 (VBUS), J12.A9 (VBUS), J12.B4 (VBUS), J12.B9 (VBUS)

Notes on the sheet:
Optional Secondary flash or PSRAM (U4), using the second chip select (XIP_SS_N[1]) on GPIO0. N.B. Pull-up R13 will be required as GPIOs default to pull-downs at power-up.
12MHz Crystal
Primary Flash
JST Debug Connector
Make sure R7 and R8 are close to RP2350
Secondary Flash/PSRAM
=== Famicom bus interface (FC-EXPSYNTH additions) ===
J10: console-side gold fingers (1-30 front / 31-60 back)
J11: 60-pin slot (pin n -> pin n incl. PPU bus and /IRQ; /ROMSEL gated in synth mode)
U10-U12: 5V bus -> 3.3V (74LVC245, VCC=3V3, DIR=GND: B->A, /OE=GND)
U13: D0-D7 bidirectional (74LVC245 at 3V3, 5V-tolerant B side; DIR=R/W: read A->B, write B->A for capture)
U14/U15: /ROMSEL gating and U13 output enable
GAME: high (default, 10k pull-up) = game mode, top cart gets every /ROMSEL cycle. GPIO30 low = synth mode (top cart sees writes only).
RW_SYN = R/W AND NOT GAME (= NOT(RW_N OR GAME))
ROMSEL_EXP = ROMSEL_N OR RW_SYN (J11 pin44; game mode: = ROMSEL_N)
RDSEL_N = ROMSEL_N OR NOT R/W ; OE1_N = RDSEL_N OR EN_N
OE_N = NOT(RW_N OR OE1) (U17: U13 on for every CPU write, and for $8000+ reads when EN)
EN_N: GPIO27 low = U13 enabled. 10k pull-up keeps it disabled at reset.
Power: console +5V and USB VBUS -> Schottky OR -> VSYS -> 3.3V LDO (IOVDD is up whenever console 5V is present)
D10: console +5V -> VSYS D11: VBUS -> VSYS (blocks back-feed)
+5V sense (GPIO40/ADC0)
Status LED, microSD (SPI0: GPIO32-35, CD=GPIO36), spare header
J14: 6 spare GPIO (GPIO31/43-47 left unrouted; GPIO30 = GAME mode select); GPIO0 is left free (PSRAM CS option via R11)

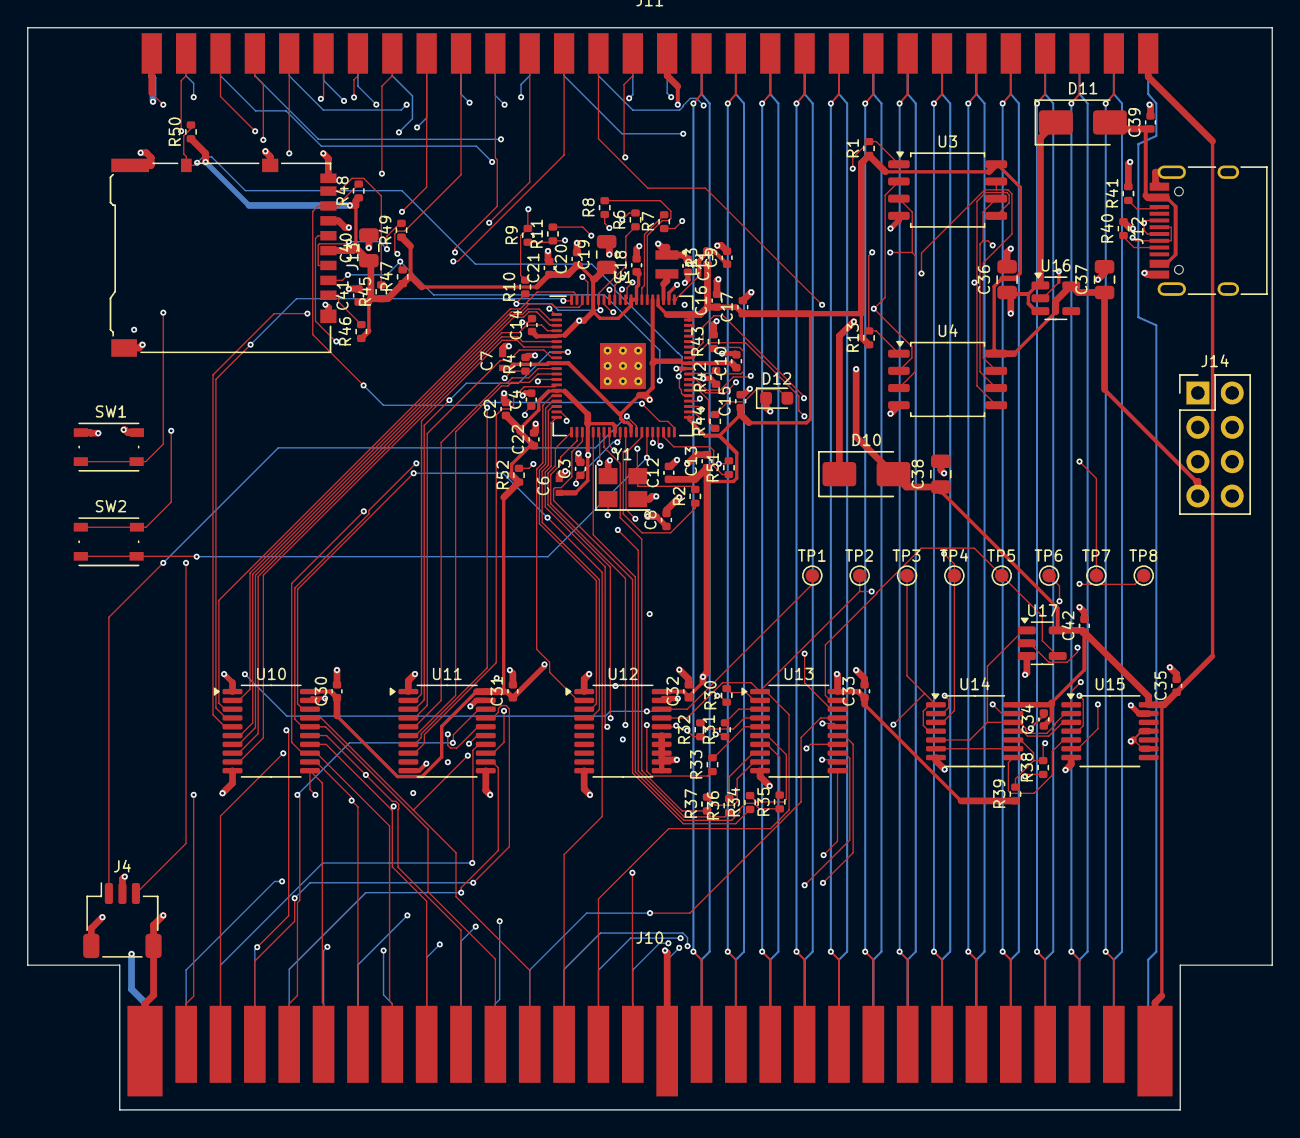
[picture p9: board FC-EXPSYNTH.kicad_pcb from above]

Board: 4 copper layers, 92.0 x 80.0 mm, 99 parts (0 on the bottom side), 149 nets.
