tresuren/FC-EXPSYNTH/(commit log)

2026-11-03 FC-EXPSYNTH Rev.E1 draft: 92x60mm single-side SMD relay cartridge (routing incomplete)
    Claude-Session: https://claude.ai/code/session_019uo68ATV27sC8Y14suo3JH
    [BOM.csv, FC-EXPSYNTH.kicad_pcb, FC-EXPSYNTH.kicad_sch, FC-EXPSYNTH_unrouted.kicad_pcb]
2026-11-04 Rev.E1: re-route with 0.15mm rules, 3V3 as routed net, TPs on back (13 unconnected left)
    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
    [FC-EXPSYNTH.kicad_pcb, FC-EXPSYNTH_unrouted.kicad_pcb]
2026-11-04 Restructure into hardware/RevE1, firmware/; no-via keepouts at card-edge pads and fingers; re-route (9 unconnected)
    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
    [BOM.csv, FC-EXPSYNTH.kicad_pcb, FC-EXPSYNTH.kicad_sch, FC-EXPSYNTH_unrouted.kicad_pcb]
2026-11-04 Finger band: no tracks/vias between contact fingers (keepouts); re-route (9 unconnected)
    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
    [FC-EXPSYNTH.kicad_pcb]
2026-11-04 Tongue: outer-layer keepout over the whole finger area (straight exits only); re-route at 60mm (7 unconnected); H_MM option
    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
    [FC-EXPSYNTH.kicad_pcb]
2026-11-07 RevE2: fully routed (0 unconnected) with 0.1mm rules; 7 caps moved to back (0603, hand-solder); J14 reduced to 2x04
    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
    [BOM.csv, FC-EXPSYNTH.kicad_pcb, FC-EXPSYNTH.kicad_sch]
2026-11-07 RevE2: refresh docs (schematic PDF, front/back renders)
    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
2026-11-07 RevE2: drop whole-tongue solder-mask openings from J10 (solder_mask_bridge 90 -> 0)
    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
    [FC-EXPSYNTH.kicad_pcb]
2026-11-07 RevE3: move microSD (J13) and USB-C (J12) to the board edge for a 3D-printed case; re-route around them (DRC 0 unconnected/clearance/short)
    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
    [BOM.csv, FC-EXPSYNTH.kicad_pcb, FC-EXPSYNTH.kicad_sch]
2026-11-07 RevE4: move RP2350 VREG inductor L1 next to U1 (LX ~20mm -> ~2mm), widen power traces where clearance allows
    - L1 (3.3uH) moved beside U1 pin 63; C11 moved to the L1 output; R3/C9 shifted right
    - re-routed +1V1 / VREG_AVDD / R3 +3V3 / C9 GND around them
    - power nets widened up to 0.4mm where 0.1mm clearance, 0.2mm hole and 0.3mm edge clearance allow
    - DRC: 0 unconnected / clearance / short; warnings only
    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
    [BOM.csv, FC-EXPSYNTH.kicad_pcb, FC-EXPSYNTH.kicad_sch]
2026-11-07 RevE4: shrink reference designator text to 0.8mm / 0.12mm stroke (silk overlaps 32 -> 21)
    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
    [FC-EXPSYNTH.kicad_pcb]
2026-11-07 RevE5 (WIP): 92x80 board, PPU+/IRQ pass-through, game/synth mode select, bidirectional data bus; placement + locked PPU lanes (routing in progress)
    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
    [BOM.csv, FC-EXPSYNTH.kicad_pcb, FC-EXPSYNTH.kicad_sch, _base.kicad_sch]
2026-11-07 RevE5 (WIP): edge track/via keep-outs (0.45mm) for the autorouter, Freerouting fixer for the 92x80 outline
    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
    [FC-EXPSYNTH.kicad_pcb]
2026-11-07 RevE5 (WIP): pre-routed compact crystal block under U1 (xtal_lanes.py)
    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
    [FC-EXPSYNTH.kicad_pcb]
2026-11-07 RevE5 (WIP): crystal block placed compactly; pre-routing optional (XTAL_LANES=1)
    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
    [FC-EXPSYNTH.kicad_pcb]
2026-11-07 RevE5: 92x80 board routed (DRC 0 unconnected/clearance/short/dangling), PPU bus + /IRQ pass-through, game/synth mode, bidirectional data bus, all parts on top
    - schematic: PPU 27 nets + IRQ_N straight J10<->J11; GAME (GPIO30, pull-up) gates ROMSEL_EXP;
    U13 -> 74LVC245 @3V3 with DIR=R/W; new U17 74LVC1G02 opens U13 on every CPU write
    - board: PPU lanes locked on B.Cu, crystal under U1, back caps moved to top,
    power nets 0.25mm min / up to 0.5mm, 0.45mm edge keep-out, ref text 0.8mm
    - BOM regenerated from the board (99 parts)
    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
    [BOM.csv, FC-EXPSYNTH.kicad_pcb]
2026-11-07 RevE5 (WIP): restore RevE3 edge positions of J13 (microSD) and J12 (USB-C); footprint keep-outs -> board rule areas
    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
2026-11-07 RevE5 (WIP): center_unlock.py (move board to sheet centre, unlock all items)
    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
